JJ-Electronics/ATinyGame/pcb-design-files/Schematic_ATinyGame-v2.png

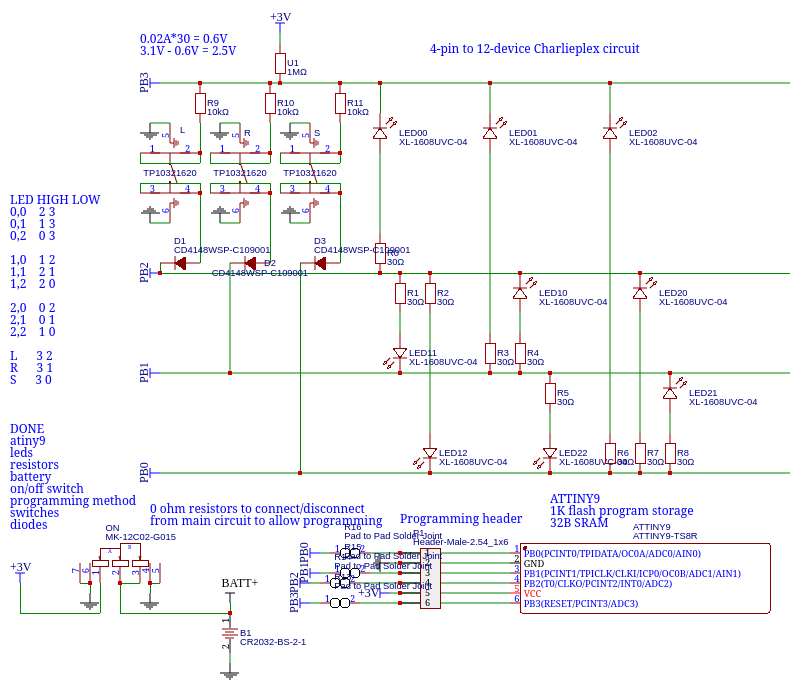
pcb-design-files/Schematic_ATinyGame-v2.png
