JJ-Electronics/ATinyGame/pcb-design-files/BOM_ATinyGame-v2.csv

ID | Name | Designator | Footprint | Quantity | Manufacturer Part | Manufacturer | Supplier | Supplier Part | Price
1 | PADTOPAD SOLDERING | U2,U3,U4,U5 | PADTOPAD SOLDERING | 4
2 | Header-Male-2.54_1x6 | P1 | HDR-6X1/2.54 | 1 | Header-Male-2.54_1x6 | LCSC | LCSC | C37208 | 0.03
3 | CR2032-BS-2-1 | B1 | BAT-TH_BS-2-1 | 1 | BS-2-1 | Q&J | LCSC | C70376 | 0.063
4 | 1MΩ | U1 | R0603 | 1 | SCR0603F1M | VO(翔胜) | LCSC | C3016422 | 0.001
5 | TP10321620 | S,R,L | SW-SMD_ROCPUSWITCHES_TP1032 | 3 | TP10321620 | ROCPU Switches(台普) | LCSC | C2999324 | 0.068
6 | 10kΩ | R11,R10,R9 | R0603 | 3 | SCR0603J10K | VO(翔胜) | LCSC | C3017715 | 0.001
7 | 30Ω | R8,R7,R6,R5,R4,R3,R2,R1,R0 | R0603 | 9 | FRC0603F30R0TS | FOJAN(富捷) | LCSC | C2907026 | 0.001
8 | MK-12C02-G015 | ON | SW-SMD_G-SWITCH_MK-12C02-G015 | 1 | MK-12C02-G015 | G-Switch(品赞) | LCSC | C2911519 | 0.119
9 | XL-1608UVC-04 | LED22,LED21,LED20,LED12,LED11,LED10,LED02,LED01,LED00 | LED0603-RD_PINK | 9 | XL-1608UVC-04 | XINGLIGHT(成兴光) | LCSC | C7371898 | 0.011
10 | CD4148WSP-C109001 | D3,D2,D1 | D0805-RD | 3 | CD4148WSP | LIZ(丽智电子) | LCSC | C109001 | 0.012
11 | ATTINY9-TS8R | ATTINY9 | SOT-23-6_L2.9-W1.6-P0.95-LS2.8-BL | 1 | ATTINY9-TS8R | MICROCHIP(美国微芯) | LCSC | C2052946 | 0.929
