JJ-Electronics/ATinyGame/(list of files, cad)

Other CAD files:
ATinyGame.obj
