JJ-Electronics/ATinyGame/pcb-design-files/Schematic_ATinyGame-v2.pdf

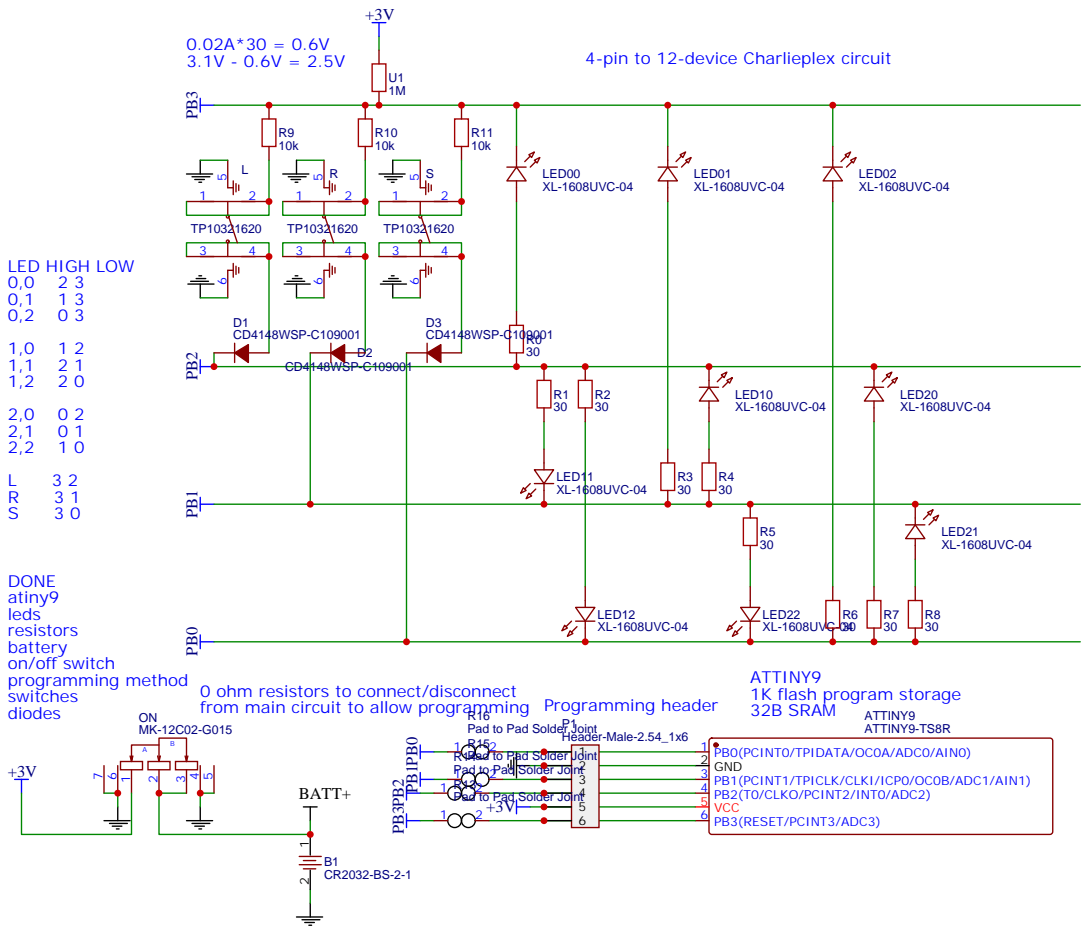
[picture p3: page 1]

4-pin to 12-device Charlieplex circuit

0 ohm resistors to connect/disconnect
from main circuit to allow programming Programming header

Pad to Pad Solder Joint
1Pad to Pad Solder Joint 2
