JJ-Electronics/ATinyGame/(commit log)

2021-12-25 avengers, assembly!
    [dump-old.txt, dump.txt]
2022-02-09 added assembly output for convenience
2024-07-25 cleaned up repo, added v2 info to readme
    [dump-old.txt]
2025-01-12 dice rolling animation
    [ATinyGame.obj]
2025-01-12 updated arduino code with new program data
2025-01-16 pcb design files
    [BOM_ATinyGame-v2.csv]
2025-01-31 golfed and added back transition state
    [ATinyGame.obj]
